phl0/b33rn4rycounter/pcb/README.md

# b33rn4ryCounter PCB

Printed circuit board for the b33rn4ry counter.

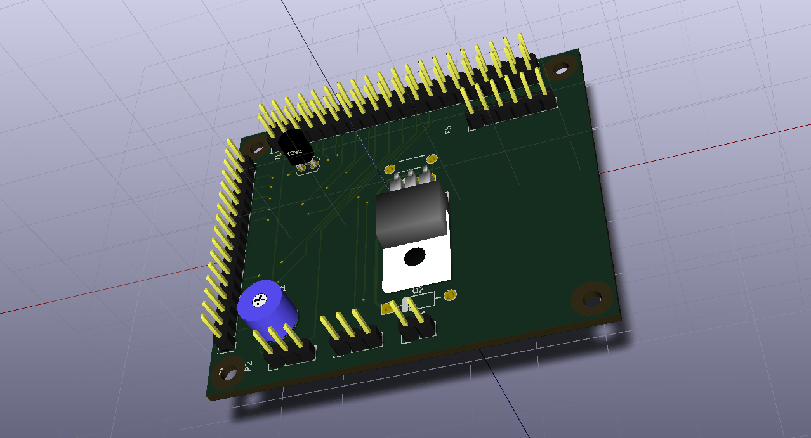
[picture p1: pcb/b33rn4ryCounterPCB.png]
PCB
