phl0/b33rn4rycounter/B33rn4ryExceptions.py

class B33rn4rySetupEventError(Exception):
  def __init__(self, value):
    self.value = value

  def __str__(self):
    return repr(self.value)

class B33rn4ryKegError(Exception):
  def __init__(self, value):
    self.value = value

  def __str__(self):
    return repr(self.value)

class DatabaseException(Exception):
  def __init__(self, value):
    self.value = value

  def __str__(self):
    return repr(self.value)

class ReaderCommError(Exception):
  def __init__(self, value):
    self.value = value

  def __str__(self):
    return repr(self.value)

class InvalidRfidReading(Exception):
  def __init__(self, value):
    self.value = value

  def __str__(self):
    return repr(self.value)

class NoneRfidReading(Exception):
  def __init__(self, value):
    self.value = value

  def __str__(self):
    return repr(self.value)
