phl0/b33rn4rycounter/(commit log)

2017-08-14 Add 1st draft of PCB
    [RPi_GPIO.sch, b33rn4ryCounterPCB.kicad_pcb, b33rn4ryCounterPCB.sch]
2017-08-15 Add 1N5000 diode
    [b33rn4ryCounterPCB.kicad_pcb, b33rn4ryCounterPCB.sch]
2019-08-21 B33rn4ryReader: add "2" prefix for serial-reader
    add this prefix to the tagdata, as it matches the data we have currently stored in the database.
2019-08-21 stop pulsuig of relais (very hackish)
    As we often have invalid-readings and Null-readings
    in between a single read of a tag, the valve gets
    closed for short during a "session".
    [B33rn4ryCounter.py, B33rn4ryExceptions.py]
